trafopajka/Ochlasta/BOM-ideas.txt

MCU
----

I need something with good timers for PWM generation.
Good bet seems to be STM32 with HRTIM. Lets fisrt try STM32F334R8T6 (it has HRTIM and cheap nucleo board is available)

Synchronous converter
----

Power FET: Infineon IRFH7440 - 40V, 11A, RDS(on)=7.5mΩ, Qg=23nC (might work for both high and low sides)
Gate driver: TI UCC27282
https://jlcpcb.com/partdetail/InfineonTechnologies-IRFH7440TRPBF/C67862

https://jlcpcb.com/partdetail/TexasInstruments-UCC27282DR/C2867844
Inductor: By calculations I need about 20 uH minimum, preferably more
For 10 A there are some available 17.8x17 mm package 1770
Maybe like this
 https://jlcpcb.com/partdetail/SOREDE-SRYH_1770YF220MT00/C5122901

Measurement:
Shunt resistor something like this:
https://jlcpcb.com/partdetail/Milliohm-HoLLR1206_1W_5mR_1/C2988648
Amplifier like this:
https://jlcpcb.com/partdetail/TexasInstruments-INA240A2DR/C2060768

Current Measurement
----
TI INA240 seems nice

Connectors
----
https://www.tme.eu/cz/en/details/xt60pw-m/dc-power-connectors/amass/ XT60 for power
https://www.tme.eu/cz/en/details/keys3557-2/car-fuseholders/keystone/3557-2/ Fuse holder

for TEC module output I propose WAGO 236 series
https://www.gme.cz/v/1499152/wago-236-744-svorkovnice-1pol-roztec-508mm-24a-320v-vstup-45-pruzina
(or similar)

For RTDs:
https://www.tme.eu/cz/en/details/mc1.5_2-g-3.81/pluggable-terminal-blocks/phoenix-contact/1803277/
https://www.tme.eu/cz/en/details/mc1.5_2-st-3.81/pluggable-terminal-blocks/phoenix-contact/1803578/

DC DC for MCU power
L 3.6 uH https://jlcpcb.com/partdetail/179254-FNR4030S3R6MT/C167871
L 2.2 uH https://jlcpcb.com/partdetail/179130-FNR3015S2R2MT/C167747

Analog LDO
----
https://jlcpcb.com/partdetail/TexasInstruments-TPS7A4901DGNR/C16430

Display
----
https://www.aliexpress.com/item/4000832671813.html (version 2")

https://www.aliexpress.com/i/1005008964559903.html (SD card has different pinout, but I believe correct mechanical dravings)

https://goldenmorninglcd.com/tft-display-module/2-inch-240x320-st7789v-gmt020-02/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 (mecahnical drawings)

Encoder
https://www.tme.eu/cz/en/details/ec11e12-15p30c-sw/incremental-type-encoders/sr-passives/

buttons:

for debug/programming small SMD buttons https://jlcpcb.com/partdetail/XUNPU-TS_1088AR02016/C720477

for user interface something like this https://www.tme.eu/cz/en/details/tact-69k-f/microswitches-tact/ninigi/

Instrumentation amplifier
----
https://jlcpcb.com/partdetail/TexasInstruments-INA333AIDGKR/C19450 (for Pt1000 RTDs)

CAN
https://jlcpcb.com/partdetail/TexasInstruments-SN65HVD230DR/C12084
