trafopajka/Ochlasta/calculations/Wheatstone_1_sch.png

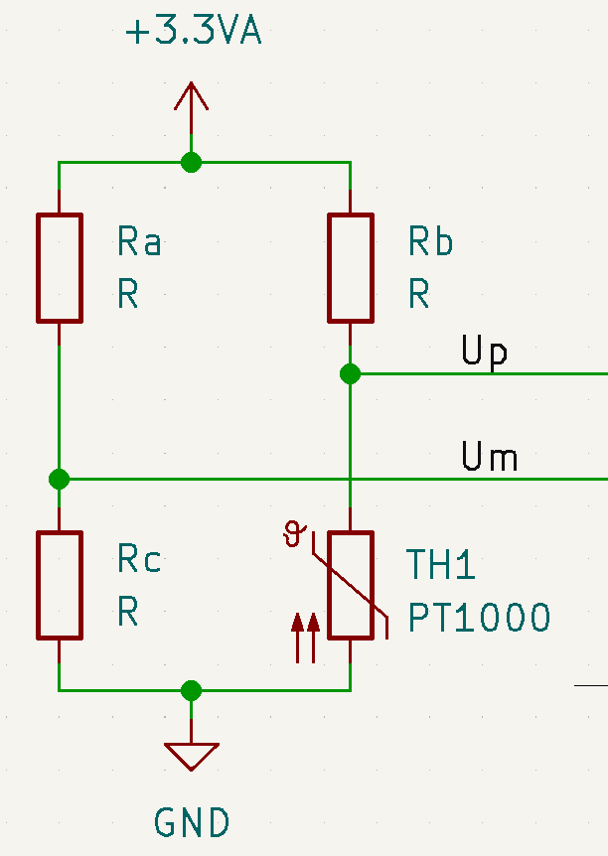
calculations/Wheatstone_1_sch.png
