trafopajka/Ochlasta/calculations/Wheatstone_2_sch.png

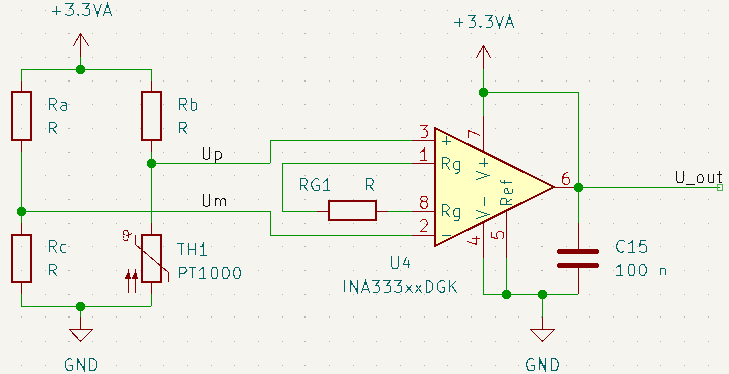
calculations/Wheatstone_2_sch.png
