trafopajka/Ochlasta/OchlastaPCB/SnapMagic_downloads/IRFH7440TRPBF.step

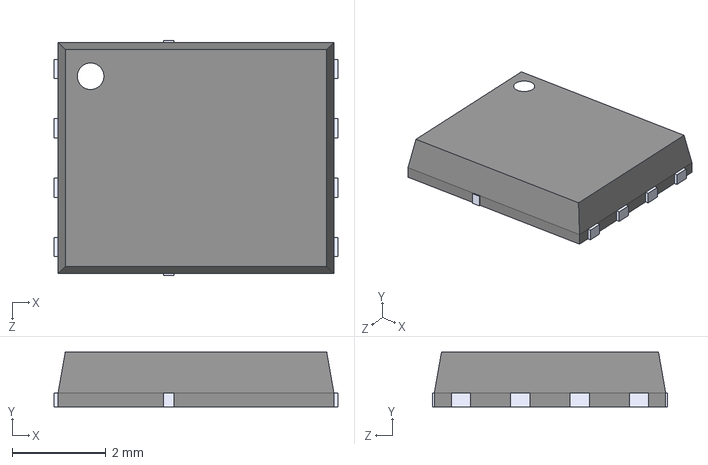
[picture p3: CAD file, 2025-11-04]
OchlastaPCB/SnapMagic_downloads/IRFH7440TRPBF.step
6.08 x 1.17 x 5.03 mm
