trafopajka/Ochlasta/OchlastaPCB/SnapMagic_downloads/TPS7A4901DGNR.step

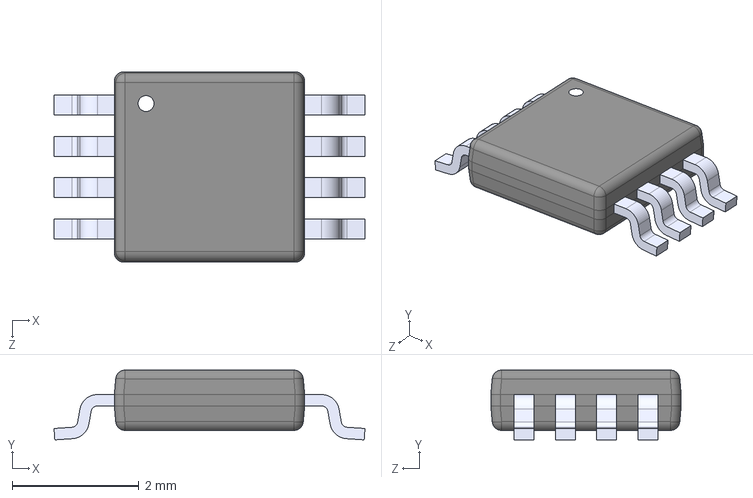
[picture p4: CAD file, 2025-10-30]
OchlastaPCB/SnapMagic_downloads/TPS7A4901DGNR.step
4.90 x 1.10 x 3.00 mm
