trafopajka/Ochlasta/OchlastaPCB/SnapMagic_downloads/XT60PW-M.step

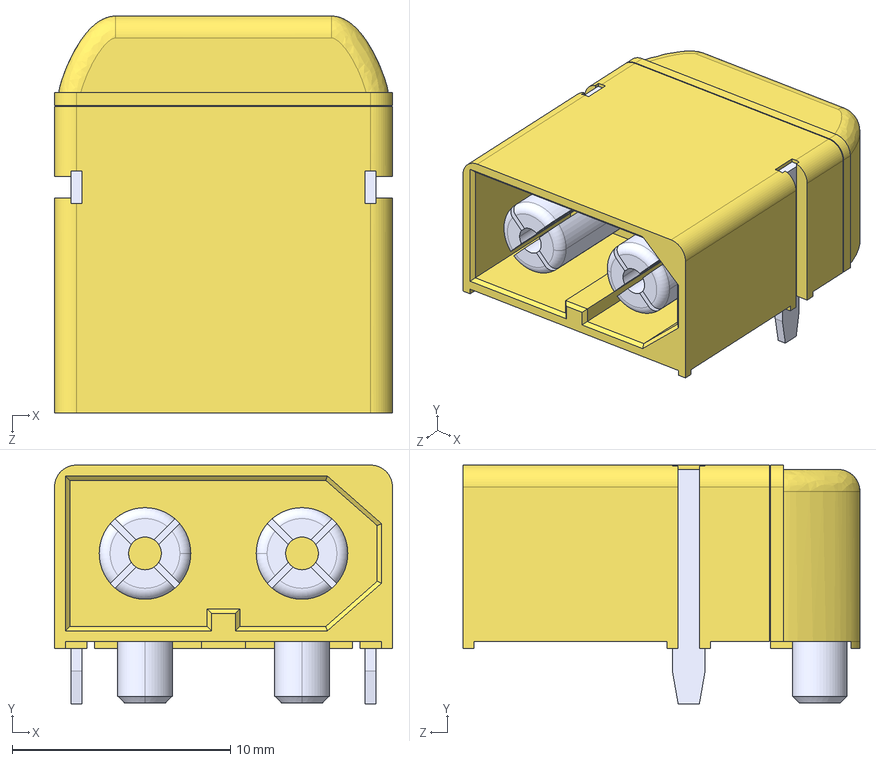
[picture p5: CAD file, 2025-10-27]
OchlastaPCB/SnapMagic_downloads/XT60PW-M.step
15.5 x 10.9 x 18.2 mm
