trafopajka/Ochlasta/OchlastaPCB/SnapMagic_downloads/UCC27282DR.step

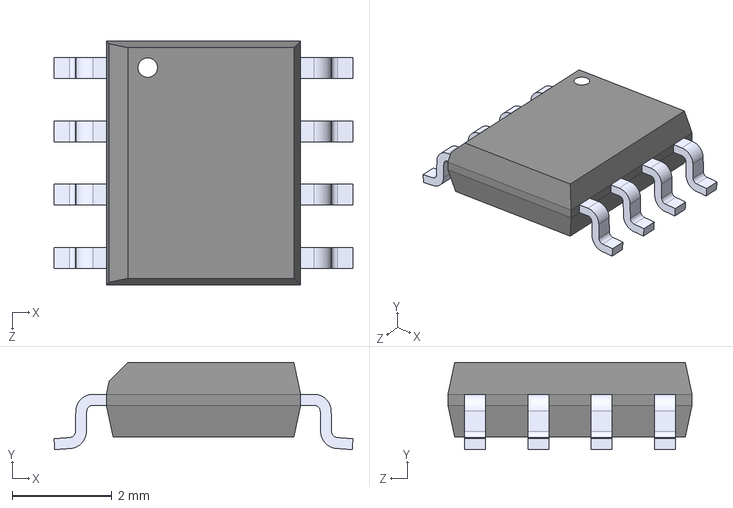
[picture p6: CAD file, 2025-11-04]
OchlastaPCB/SnapMagic_downloads/UCC27282DR.step
6.00 x 1.75 x 4.90 mm
