trafopajka/Ochlasta/OchlastaPCB/SnapMagic_downloads/AP64501SP-13.step

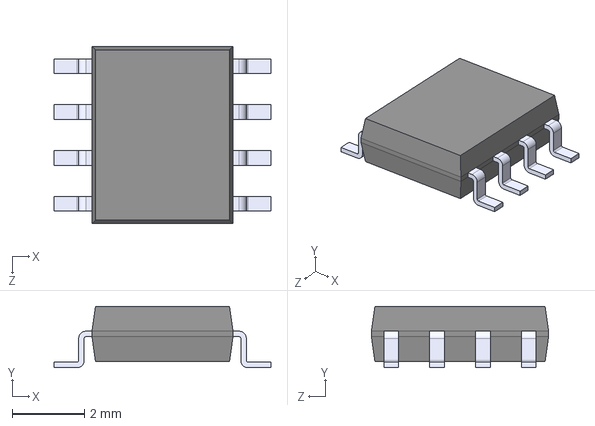
[picture p7: CAD file, 2025-10-27]
OchlastaPCB/SnapMagic_downloads/AP64501SP-13.step
6.00 x 1.70 x 4.90 mm
