trafopajka/Ochlasta/OchlastaPCB/OchlastaPCB.kicad_pcb

## KiCad design OchlastaPCB/OchlastaPCB.kicad_pcb (2025-11-10)

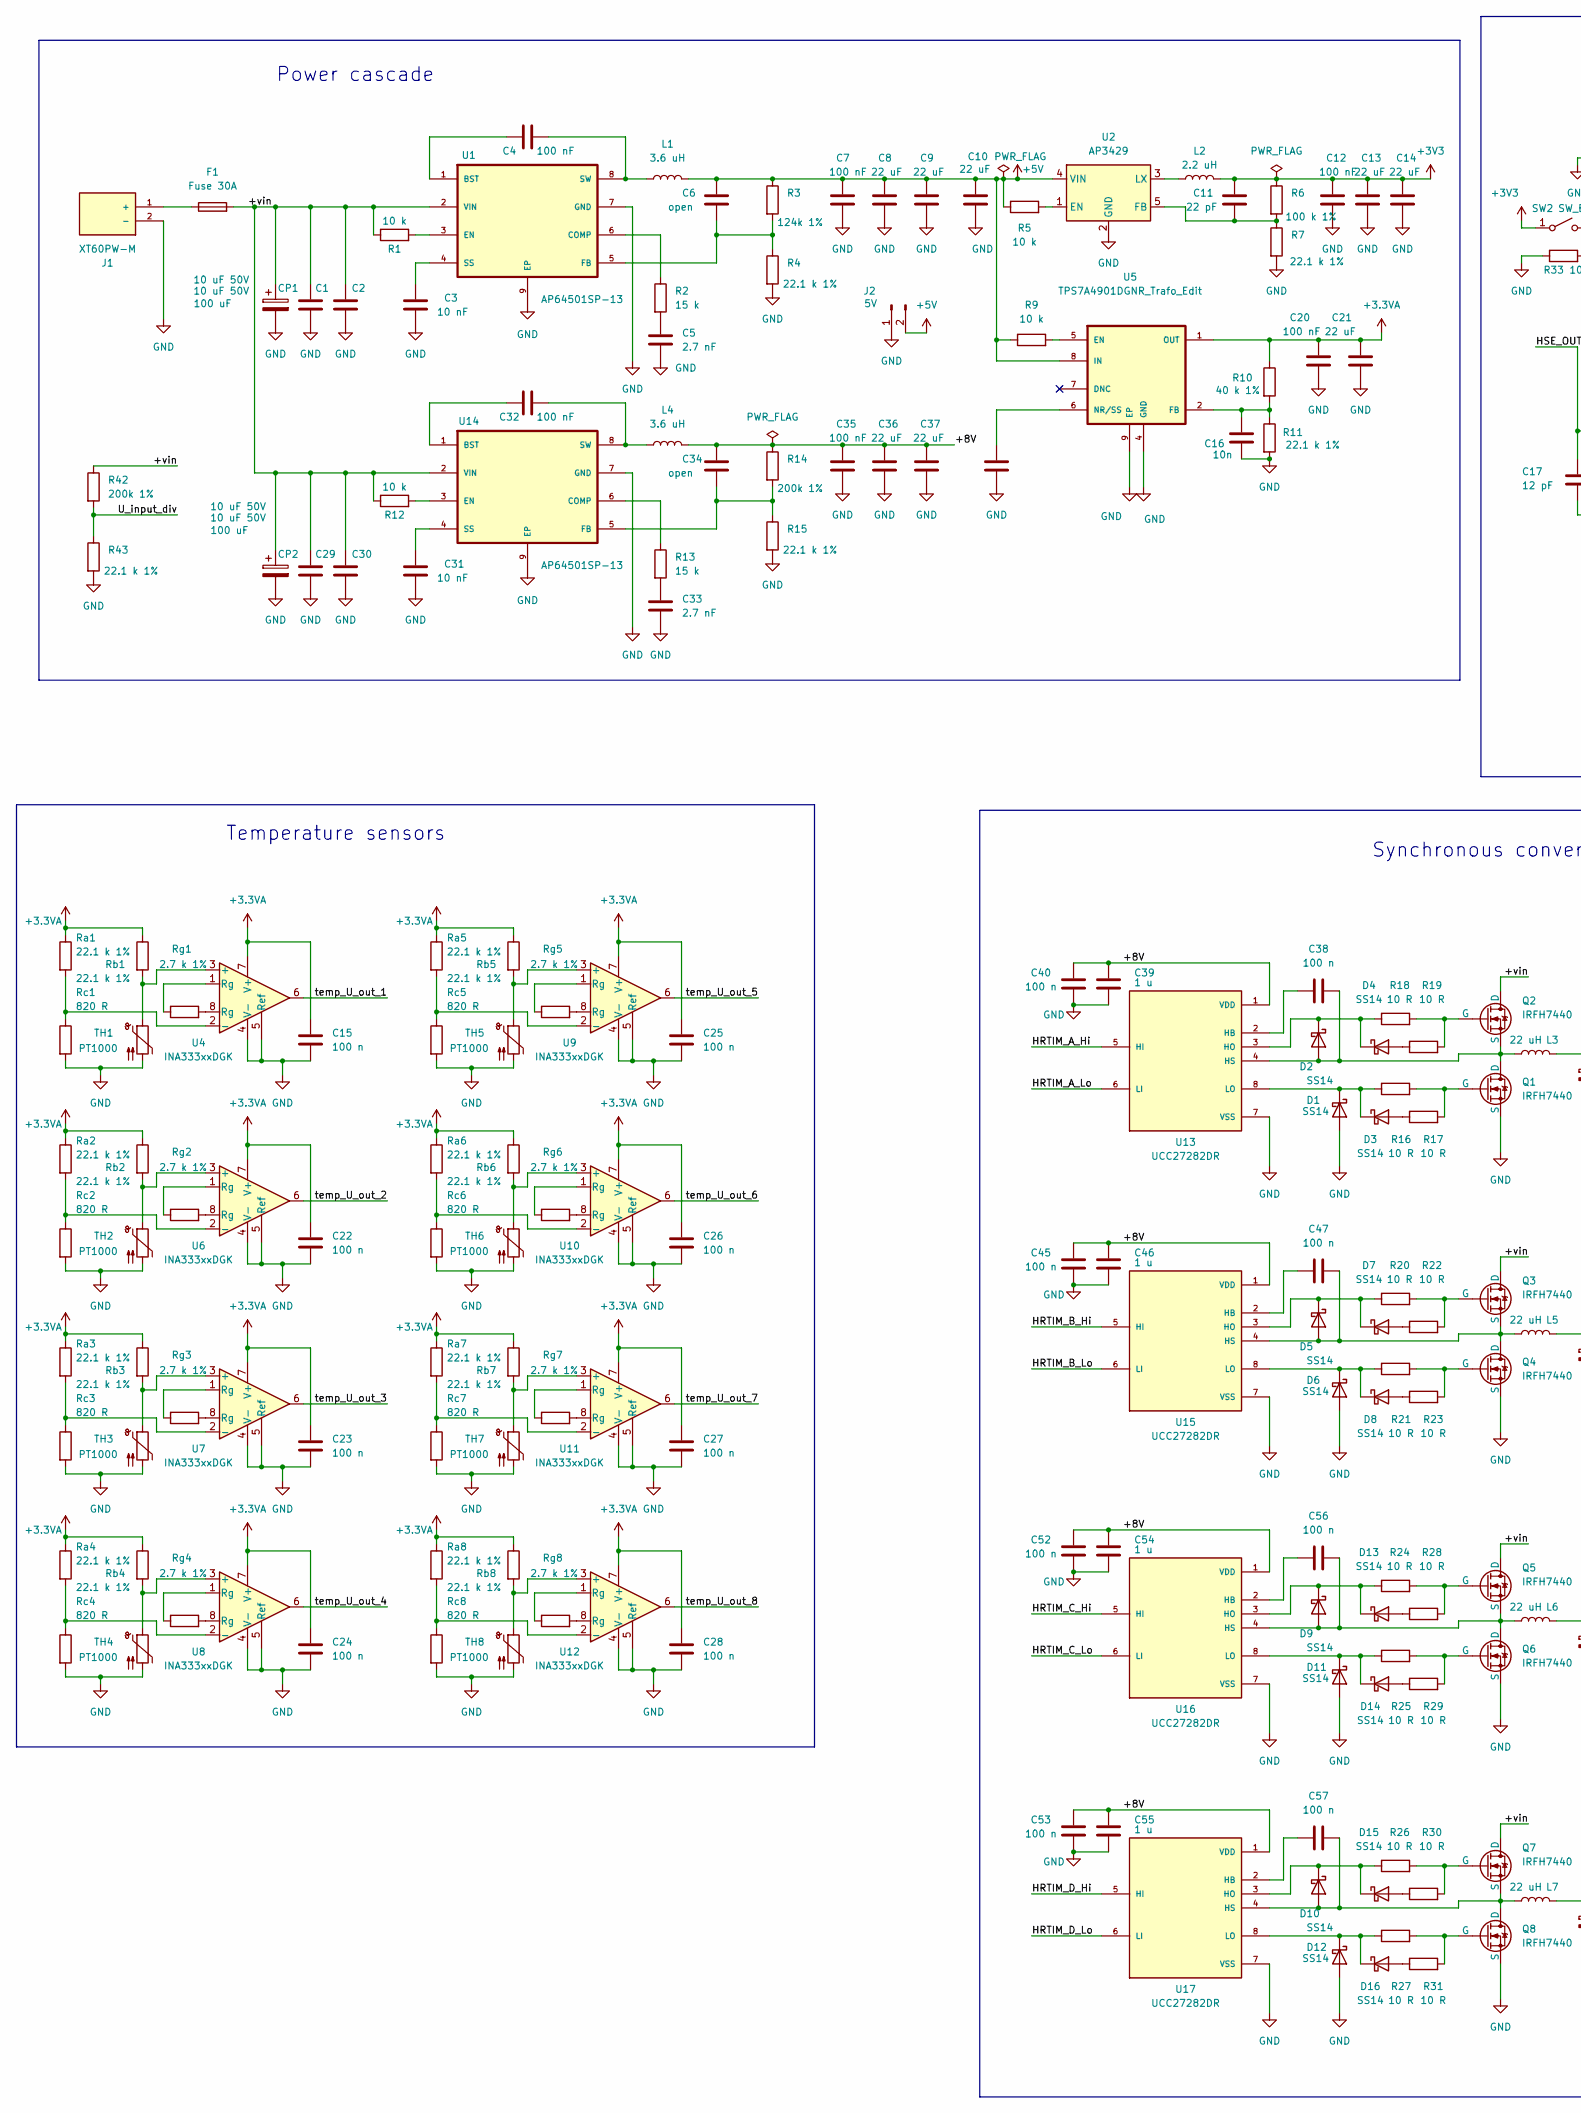
[picture p8: schematic OchlastaPCB.kicad_sch, Ochlasta, part in row 1, column 1]

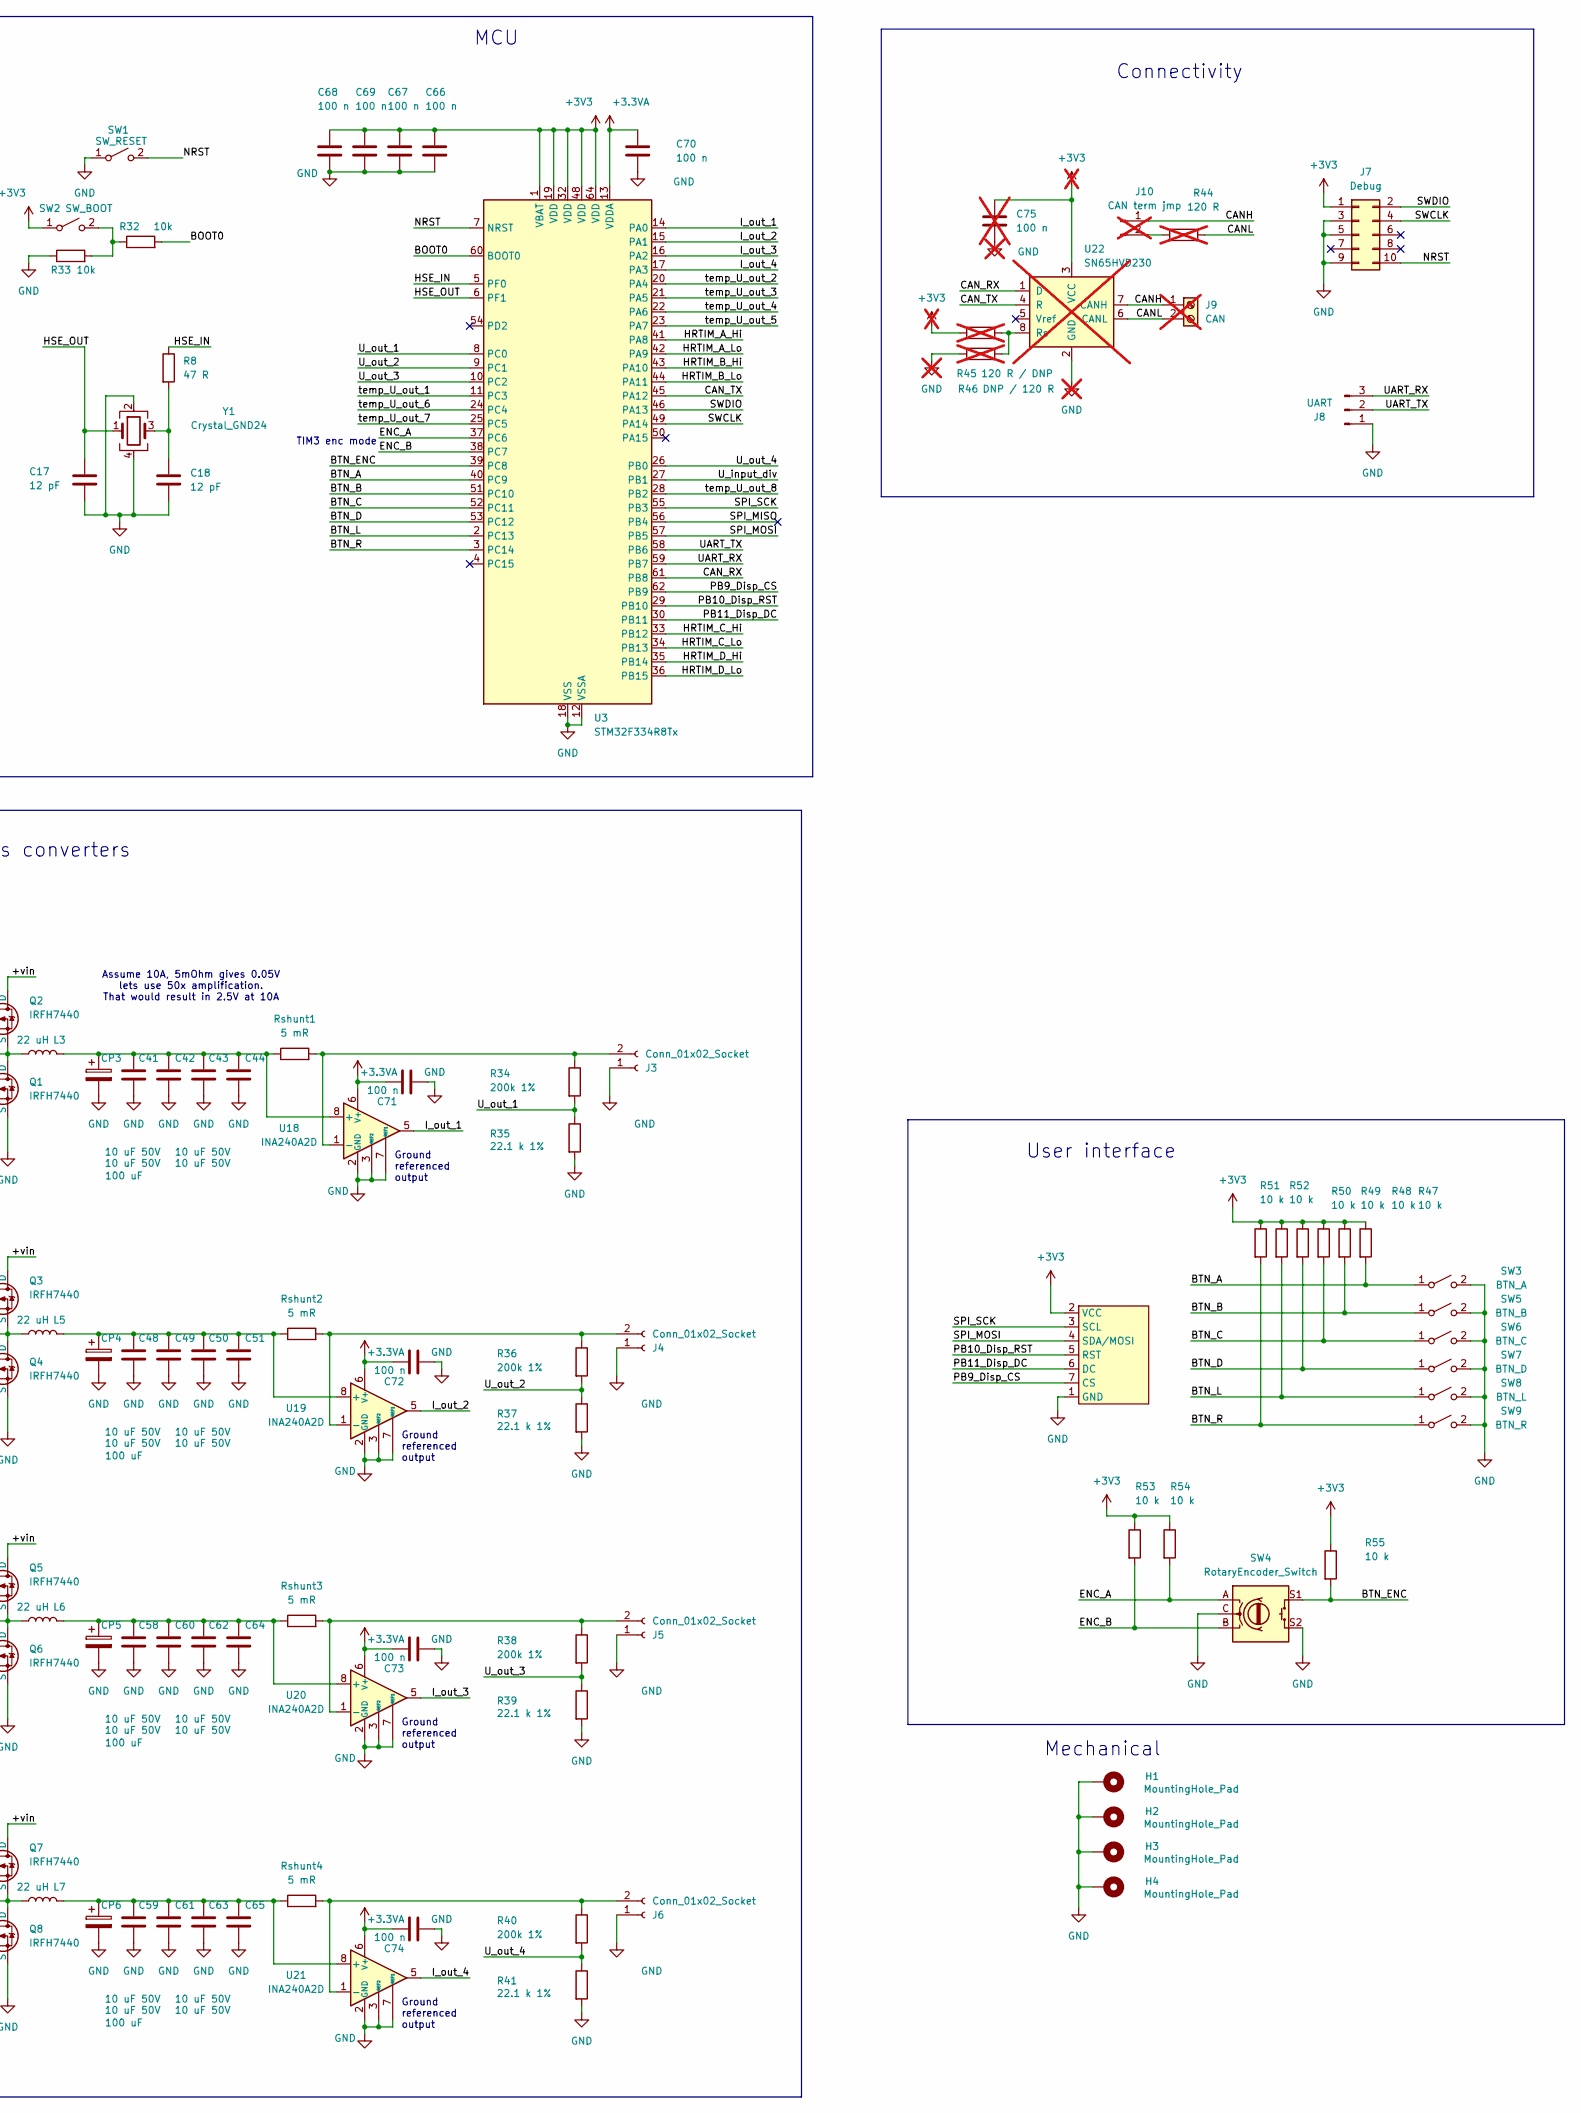
[picture p9: schematic OchlastaPCB.kicad_sch, Ochlasta, part in row 1, column 2]

Parts:
C1, C2, C29, C30, C41, C42, C43, C44, C48, C49, C50, C51, C58, C59, C60, C61, C62, C63, C64, C65: 10 uF 50V; C_1206_3216Metric
C3, C31: 10 nF; C_0603_1608Metric
C4, C7, C12, C20, C32, C35: 100 nF; C_0603_1608Metric
C5, C33: 2.7 nF; C_0603_1608Metric
C6, C34: open; C_0603_1608Metric
C8, C9, C10, C13, C14, C21, C36, C37: 22 uF; C_0805_2012Metric
C11: 22 pF; C_0603_1608Metric
C15, C22, C23, C24, C25, C26, C27, C28, C38, C40, C45, C47, C52, C53, C56, C57, C66, C67, C68, C69, C70, C71, C72, C73, C74: 100 n; C_0603_1608Metric
C16, C19: 10n; C_0603_1608Metric
C17, C18: 12 pF; C_0603_1608Metric
C39, C46, C54, C55: 1 u; C_0603_1608Metric
C75: 100 n; C_0603_1608Metric; not fitted
CP1, CP2, CP3, CP4, CP5, CP6: 100 uF; CP_Elec_8x10
D1, D2, D3, D4, D5, D6, D7, D8, D9, D10, D11, D12, D13, D14, D15, D16: SS14; D_SMA
F1: Fuse 30A; Fuseholder_Keystone_3557
H1, H2, H3, H4: MountingHole_Pad; MountingHole_3.2mm_M3_Pad_Via
J1: XT60PW-M; AMASS_XT60PW-M; PARTREV V1.2
J2: 5V; PinHeader_1x02_P2.54mm_Vertical
J3, J4, J5, J6: Conn_01x02_Socket; TerminalBlock_WAGO_236-402_1x02_P5.00mm_45Degree
J7: Debug; IDC-Header_2x05_P2.54mm_Vertical
J8: UART; PinHeader_1x03_P2.54mm_Vertical
J9: CAN; PhoenixContact_MC_1,5_2-G-3.81_1x02_P3.81mm_Horizontal; not fitted
J10: CAN term jmp; PinHeader_1x02_P2.54mm_Vertical; not fitted
L1, L4: 3.6 uH; L_Changjiang_FNR4030S
L2: 2.2 uH; L_Changjiang_FNR3015S
L3, L5, L6, L7: 22 uH; L_APV_APH1770
Q1, Q2, Q3, Q4, Q5, Q6, Q7, Q8: IRFH7440; PQFN_5x6_FET
R1, R5, R9, R12, R47, R48, R49, R50, R51, R52, R53, R54, R55: 10 k; R_0603_1608Metric
R2, R13: 15 k; R_0603_1608Metric
R3: 124k 1%; R_0603_1608Metric
R4, R7, R11, R15, R35, R37, R39, R41, R43: 22.1 k 1%; R_0603_1608Metric
R6: 100 k 1%; R_0603_1608Metric
R8: 47 R; R_0603_1608Metric
R10: 40 k 1%; R_0603_1608Metric
R14, R34, R36, R38, R40, R42: 200k 1%; R_0603_1608Metric
R16, R17, R18, R19, R20, R21, R22, R23, R24, R25, R26, R27, R28, R29, R30, R31: 10 R; R_0603_1608Metric
R32, R33: 10k; R_0603_1608Metric
R44: 120 R; R_0603_1608Metric; not fitted
R45: 120 R / DNP; R_0603_1608Metric; not fitted
R46: DNP / 120 R; R_0603_1608Metric; not fitted
Ra1, Ra2, Ra3, Ra4, Ra5, Ra6, Ra7, Ra8: 22.1 k 1%; R_0603_1608Metric
Rb1, Rb2, Rb3, Rb4, Rb5, Rb6, Rb7, Rb8: 22.1 k 1%; R_0603_1608Metric
Rc1, Rc2, Rc3, Rc4, Rc5, Rc6, Rc7, Rc8: 820 R; R_0603_1608Metric
Rg1, Rg2, Rg3, Rg4, Rg5, Rg6, Rg7, Rg8: 2.7 k 1%; R_0603_1608Metric
Rshunt1, Rshunt2, Rshunt3, Rshunt4: 5 mR; R_1206_3216Metric
SW1: SW_RESET; SW_Push_SPST_CheapAtJLC
SW2: SW_BOOT; SW_Push_SPST_CheapAtJLC
SW3: BTN_A; SW_PUSH_6mm
SW4: RotaryEncoder_Switch; RotaryEncoder_Alps_EC11E-Switch_Vertical_H20mm
SW5: BTN_B; SW_PUSH_6mm
SW6: BTN_C; SW_PUSH_6mm
SW7: BTN_D; SW_PUSH_6mm
SW8: BTN_L; SW_PUSH_6mm
SW9: BTN_R; SW_PUSH_6mm
TFT1: GMT020-02 TFT Display
TH1, TH2, TH3, TH4, TH5, TH6, TH7, TH8: PT1000; PhoenixContact_MC_1,5_2-G-3.81_1x02_P3.81mm_Horizontal
U1, U14: AP64501SP-13; SOIC127P600X170-9N
U2: AP3429; TSOT-23-5
U3: STM32F334R8Tx; LQFP-64_10x10mm_P0.5mm
U4, U6, U7, U8, U9, U10, U11, U12: INA333xxDGK; VSSOP-8_3x3mm_P0.65mm
U5: TPS7A4901DGNR_Trafo_Edit; SOP65P490X110-9N
U13, U15, U16, U17: UCC27282DR; SOIC127P599X175-8N; PARTREV A
U18, U19, U20, U21: INA240A2D; SOIC-8_3.9x4.9mm_P1.27mm
U22: SN65HVD230; SOIC-8_3.9x4.9mm_P1.27mm; not fitted
Y1: Crystal_GND24; Crystal_SMD_3225-4Pin_3.2x2.5mm

Connections:
+3.3VA: C15.1, C20.1, C21.1, C22.1, C23.1, C24.1, C25.1, C26.1, C27.1, C28.1, C70.1, C71.1, C72.1, C73.1, C74.1, R10.1, Ra1.1, Ra2.1, Ra3.1, Ra4.1, Ra5.1, Ra6.1, Ra7.1, Ra8.1, Rb1.1, Rb2.1, Rb3.1, Rb4.1, Rb5.1, Rb6.1, Rb7.1, Rb8.1, U3.13 (VDDA), U4.7 (V+), U5.1 (OUT), U6.7 (V+), U7.7 (V+), U8.7 (V+), U9.7 (V+), U10.7 (V+), U11.7 (V+), U12.7 (V+), U18.6 (V+), U19.6 (V+), U20.6 (V+), U21.6 (V+)
+3V3: C11.1, C12.1, C13.1, C14.1, C66.1, C67.1, C68.1, C69.1, C75.1, J7.1, L2.2, R6.1, R45.1, R47.1, R48.1, R49.1, R50.1, R51.1, R52.1, R53.1, R54.1, R55.1, SW2.1 (A), TFT1.2 (VCC), U3.1 (VBAT), U3.19 (VDD), U3.32 (VDD), U3.48 (VDD), U3.64 (VDD), U22.3 (VCC)
+5V: C6.1, C7.1, C8.1, C9.1, C10.1, J2.2, L1.2, R3.1, R5.1, R9.1, U2.4 (VIN), U5.8 (IN)
/+8V: C34.1, C35.1, C36.1, C37.1, C39.2, C40.2, C45.2, C46.2, C52.2, C53.2, C54.2, C55.2, L4.2, R14.1, U13.1 (VDD), U15.1 (VDD), U16.1 (VDD), U17.1 (VDD)
/+vin: C1.1, C2.1, C29.1, C30.1, CP1.1, CP2.1, F1.2, Q2.1 (D), Q3.1 (D), Q5.1 (D), Q7.1 (D), R1.1, R12.1, R42.1, U1.2 (VIN), U14.2 (VIN)
/BOOT0: R32.2, U3.60 (BOOT0)
/BTN_A: R47.2, SW3.1 (A), U3.40 (PC9)
/BTN_B: R48.2, SW5.1 (A), U3.51 (PC10)
/BTN_C: R49.2, SW6.1 (A), U3.52 (PC11)
/BTN_D: R50.2, SW7.1 (A), U3.53 (PC12)
/BTN_ENC: R55.2, SW4.S1, U3.39 (PC8)
/BTN_L: R52.2, SW8.1 (A), U3.2 (PC13)
/BTN_R: R51.2, SW9.1 (A), U3.3 (PC14)
/CANH: J9.1, J10.1, U22.7 (CANH)
/CANL: J9.2, R44.2, U22.6 (CANL)
/CAN_RX: U3.61 (PB8), U22.1 (D)
/CAN_TX: U3.45 (PA12), U22.4 (R)
/ENC_A: R54.2, SW4.A, U3.37 (PC6)
/ENC_B: R53.2, SW4.B, U3.38 (PC7)
/HRTIM_A_Hi: U3.41 (PA8), U13.5 (HI)
/HRTIM_A_Lo: U3.42 (PA9), U13.6 (LI)
/HRTIM_B_Hi: U3.43 (PA10), U15.5 (HI)
/HRTIM_B_Lo: U3.44 (PA11), U15.6 (LI)
/HRTIM_C_Hi: U3.33 (PB12), U16.5 (HI)
/HRTIM_C_Lo: U3.34 (PB13), U16.6 (LI)
/HRTIM_D_Hi: U3.35 (PB14), U17.5 (HI)
/HRTIM_D_Lo: U3.36 (PB15), U17.6 (LI)
/HSE_IN: R8.1, U3.5 (PF0)
/HSE_OUT: C17.1, U3.6 (PF1), Y1.1
/I_out_1: U3.14 (PA0), U18.5
/I_out_2: U3.15 (PA1), U19.5
/I_out_3: U3.16 (PA2), U20.5
/I_out_4: U3.17 (PA3), U21.5
/NRST: J7.10, SW1.2 (B), U3.7 (NRST)
/PB9_Disp_CS: TFT1.7 (CS), U3.62 (PB9)
/PB10_Disp_RST: TFT1.5 (RST), U3.29 (PB10)
/PB11_Disp_DC: TFT1.6 (DC), U3.30 (PB11)
/SPI_MISO: U3.56 (PB4)
/SPI_MOSI: TFT1.4 (SDA/MOSI), U3.57 (PB5)
/SPI_SCK: TFT1.3 (SCL), U3.55 (PB3)
/SWCLK: J7.4, U3.49 (PA14)
/SWDIO: J7.2, U3.46 (PA13)
/UART_RX: J8.3, U3.59 (PB7)
/UART_TX: J8.2, U3.58 (PB6)
/U_input_div: R42.2, R43.1, U3.27 (PB1)
/U_out_1: R34.2, R35.1, U3.8 (PC0)
/U_out_2: R36.2, R37.1, U3.9 (PC1)
/U_out_3: R38.2, R39.1, U3.10 (PC2)
/U_out_4: R40.2, R41.1, U3.26 (PB0)
/temp_U_out_1: U3.11 (PC3), U4.6
/temp_U_out_2: U3.20 (PA4), U6.6
/temp_U_out_3: U3.21 (PA5), U7.6
/temp_U_out_4: U3.22 (PA6), U8.6
/temp_U_out_5: U3.23 (PA7), U9.6
/temp_U_out_6: U3.24 (PC4), U10.6
/temp_U_out_7: U3.25 (PC5), U11.6
/temp_U_out_8: U3.28 (PB2), U12.6
GND: C1.2, C2.2, C3.2, C5.2, C7.2, C8.2, C9.2, C10.2, C12.2, C13.2, C14.2, C15.2, C16.2, C17.2, C18.2, C19.2, C20.2, C21.2, C22.2, C23.2, C24.2, C25.2, C26.2, C27.2, C28.2, C29.2, C30.2, C31.2, C33.2, C35.2, C36.2, C37.2, C39.1, C40.1, C41.2, C42.2, C43.2, C44.2, C45.1, C46.1, C48.2, C49.2, C50.2, C51.2, C52.1, C53.1, C54.1, C55.1, C58.2, C59.2, C60.2, C61.2, C62.2, C63.2, C64.2, C65.2, C66.2, C67.2, C68.2, C69.2, C70.2, C71.2, C72.2, C73.2, C74.2, C75.2, CP1.2, CP2.2, CP3.2, CP4.2, CP5.2, CP6.2, D1.2 (A), D6.2 (A), D11.2 (A), D12.2 (A), H1.1, H2.1, H3.1, H4.1, J1.2 (-), J2.1, J3.1, J4.1, J5.1, J6.1, J7.3, J7.5, J7.9, J8.1, Q1.3 (S), Q4.3 (S), Q6.3 (S), Q8.3 (S), R4.2, R7.2, R11.2, R15.2, R33.1, R35.2, R37.2, R39.2, R41.2, R43.2, R46.1, Rc1.2, Rc2.2, Rc3.2, Rc4.2, Rc5.2, Rc6.2, Rc7.2, Rc8.2, SW1.1 (A), SW3.2 (B), SW4.C, SW4.S2, SW5.2 (B), SW6.2 (B), SW7.2 (B), SW8.2 (B), SW9.2 (B), TFT1.1 (GND), TH1.2, TH2.2, TH3.2, TH4.2, TH5.2, TH6.2, TH7.2, TH8.2, U1.7 (GND), U1.9 (EP), U2.2 (GND), U3.12 (VSSA), U3.18 (VSS), U3.31 (VSS), U3.47 (VSS), U3.63 (VSS), U4.4 (V-), U4.5 (Ref), U5.4 (GND), U5.9 (EP), U6.4 (V-), U6.5 (Ref), U7.4 (V-), U7.5 (Ref), U8.4 (V-), U8.5 (Ref), U9.4 (V-), U9.5 (Ref), U10.4 (V-), U10.5 (Ref), U11.4 (V-), U11.5 (Ref), U12.4 (V-), U12.5 (Ref), U13.7 (VSS), U14.7 (GND), U14.9 (EP), U15.7 (VSS), U16.7 (VSS), U17.7 (VSS), U18.2 (GND), U18.3 (REF2), U18.4 (GND), U18.7 (REF1), U19.2 (GND), U19.3 (REF2), U19.4 (GND), U19.7 (REF1), U20.2 (GND), U20.3 (REF2), U20.4 (GND), U20.7 (REF1), U21.2 (GND), U21.3 (REF2), U21.4 (GND), U21.7 (REF1), U22.2 (GND), Y1.2, Y1.4
unnamed: C5.1, R2.2
unnamed: C18.1, R8.2, Y1.3
unnamed: C33.1, R13.2
unnamed: D1.1 (K), D3.1 (K), R16.1, U13.8 (LO)
unnamed: C38.2, D2.2 (A), L3.1, Q1.1 (D), Q2.3 (S), U13.4 (HS)
unnamed: D2.1 (K), D4.1 (K), R18.1, U13.3 (HO)
unnamed: D3.2 (A), R17.1
unnamed: D4.2 (A), R19.1
unnamed: C47.2, D5.2 (A), L5.1, Q3.3 (S), Q4.1 (D), U15.4 (HS)
unnamed: D5.1 (K), D7.1 (K), R20.1, U15.3 (HO)
unnamed: D6.1 (K), D8.1 (K), R21.1, U15.8 (LO)
unnamed: D7.2 (A), R22.1
unnamed: D8.2 (A), R23.1
unnamed: C56.2, D9.2 (A), L6.1, Q5.3 (S), Q6.1 (D), U16.4 (HS)
unnamed: C57.2, D10.2 (A), L7.1, Q7.3 (S), Q8.1 (D), U17.4 (HS)
unnamed: D10.1 (K), D15.1 (K), R26.1, U17.3 (HO)
unnamed: D11.1 (K), D14.1 (K), R25.1, U16.8 (LO)
unnamed: D12.1 (K), D16.1 (K), R27.1, U17.8 (LO)
unnamed: D13.2 (A), R28.1
unnamed: D9.1 (K), D13.1 (K), R24.1, U16.3 (HO)
unnamed: D14.2 (A), R29.1
unnamed: D15.2 (A), R30.1
unnamed: D16.2 (A), R31.1
unnamed: F1.1, J1.1 (+)
unnamed: J3.2, R34.1, Rshunt1.2, U18.1 (-)
unnamed: J4.2, R36.1, Rshunt2.2, U19.1 (-)
unnamed: J5.2, R38.1, Rshunt3.2, U20.1 (-)
unnamed: J6.2, R40.1, Rshunt4.2, U21.1 (-)
unnamed: J10.2, R44.1
unnamed: Q1.2 (G), R16.2, R17.2
unnamed: Q2.2 (G), R18.2, R19.2
unnamed: Q3.2 (G), R20.2, R22.2
unnamed: Q4.2 (G), R21.2, R23.2
unnamed: Q5.2 (G), R24.2, R28.2
unnamed: Q6.2 (G), R25.2, R29.2
unnamed: Q7.2 (G), R26.2, R30.2
unnamed: Q8.2 (G), R27.2, R31.2
unnamed: Rg1.1, U4.1 (Rg)
unnamed: Rg1.2, U4.8 (Rg)
unnamed: Rg2.1, U6.1 (Rg)
unnamed: Rg2.2, U6.8 (Rg)
unnamed: Rg3.1, U7.1 (Rg)
unnamed: Rg3.2, U7.8 (Rg)
unnamed: Rg4.1, U8.1 (Rg)
unnamed: Rg4.2, U8.8 (Rg)
unnamed: Rg5.1, U9.1 (Rg)
unnamed: Rg5.2, U9.8 (Rg)
unnamed: Rg6.1, U10.1 (Rg)
unnamed: Rg6.2, U10.8 (Rg)
unnamed: Rg7.1, U11.1 (Rg)
unnamed: Rg7.2, U11.8 (Rg)
unnamed: Rg8.1, U12.1 (Rg)
unnamed: Rg8.2, U12.8 (Rg)
unnamed: R32.1, R33.2, SW2.2 (B)
unnamed: C4.1, U1.1 (BST)
unnamed: R2.1, U1.6 (COMP)
unnamed: R1.2, U1.3 (EN)
unnamed: C6.2, R3.2, R4.1, U1.5 (FB)
unnamed: C3.1, U1.4 (SS)
unnamed: C4.2, L1.1, U1.8 (SW)
unnamed: R5.2, U2.1 (EN)
unnamed: C11.2, R6.2, R7.1, U2.5 (FB)
unnamed: L2.1, U2.3 (LX)
unnamed: Rb1.2, TH1.1, U4.3 (+)
unnamed: Ra1.2, Rc1.1, U4.2 (-)
unnamed: R9.2, U5.5 (EN)
unnamed: C16.1, R10.2, R11.1, U5.2 (FB)
unnamed: C19.1, U5.6 (NR/SS)
unnamed: Rb2.2, TH2.1, U6.3 (+)
unnamed: Ra2.2, Rc2.1, U6.2 (-)
unnamed: Rb3.2, TH3.1, U7.3 (+)
unnamed: Ra3.2, Rc3.1, U7.2 (-)
unnamed: Rb4.2, TH4.1, U8.3 (+)
unnamed: Ra4.2, Rc4.1, U8.2 (-)
unnamed: Rb5.2, TH5.1, U9.3 (+)
unnamed: Ra5.2, Rc5.1, U9.2 (-)
unnamed: Rb6.2, TH6.1, U10.3 (+)
unnamed: Ra6.2, Rc6.1, U10.2 (-)
unnamed: Rb7.2, TH7.1, U11.3 (+)
unnamed: Ra7.2, Rc7.1, U11.2 (-)
unnamed: Rb8.2, TH8.1, U12.3 (+)
unnamed: Ra8.2, Rc8.1, U12.2 (-)
unnamed: C38.1, U13.2 (HB)
unnamed: C32.1, U14.1 (BST)
unnamed: R13.1, U14.6 (COMP)
unnamed: R12.2, U14.3 (EN)
unnamed: C34.2, R14.2, R15.1, U14.5 (FB)
unnamed: C31.1, U14.4 (SS)
unnamed: C32.2, L4.1, U14.8 (SW)
unnamed: C47.1, U15.2 (HB)
unnamed: C56.1, U16.2 (HB)
unnamed: C57.1, U17.2 (HB)
unnamed: C41.1, C42.1, C43.1, C44.1, CP3.1, L3.2, Rshunt1.1, U18.8 (+)
unnamed: C48.1, C49.1, C50.1, C51.1, CP4.1, L5.2, Rshunt2.1, U19.8 (+)
unnamed: C58.1, C60.1, C62.1, C64.1, CP5.1, L6.2, Rshunt3.1, U20.8 (+)
unnamed: C59.1, C61.1, C63.1, C65.1, CP6.1, L7.2, Rshunt4.1, U21.8 (+)
unnamed: R45.2, R46.2, U22.8 (Rs)

Notes on the sheet:
Temperature sensors
Power cascade
User interface
Ground referenced output
Connectivity
MCU
Synchronous converters
Mechanical
TIM3 enc mode
Assume 10A, 5mOhm gives 0.05V lets use 50x amplification. That would result in 2.5V at 10A

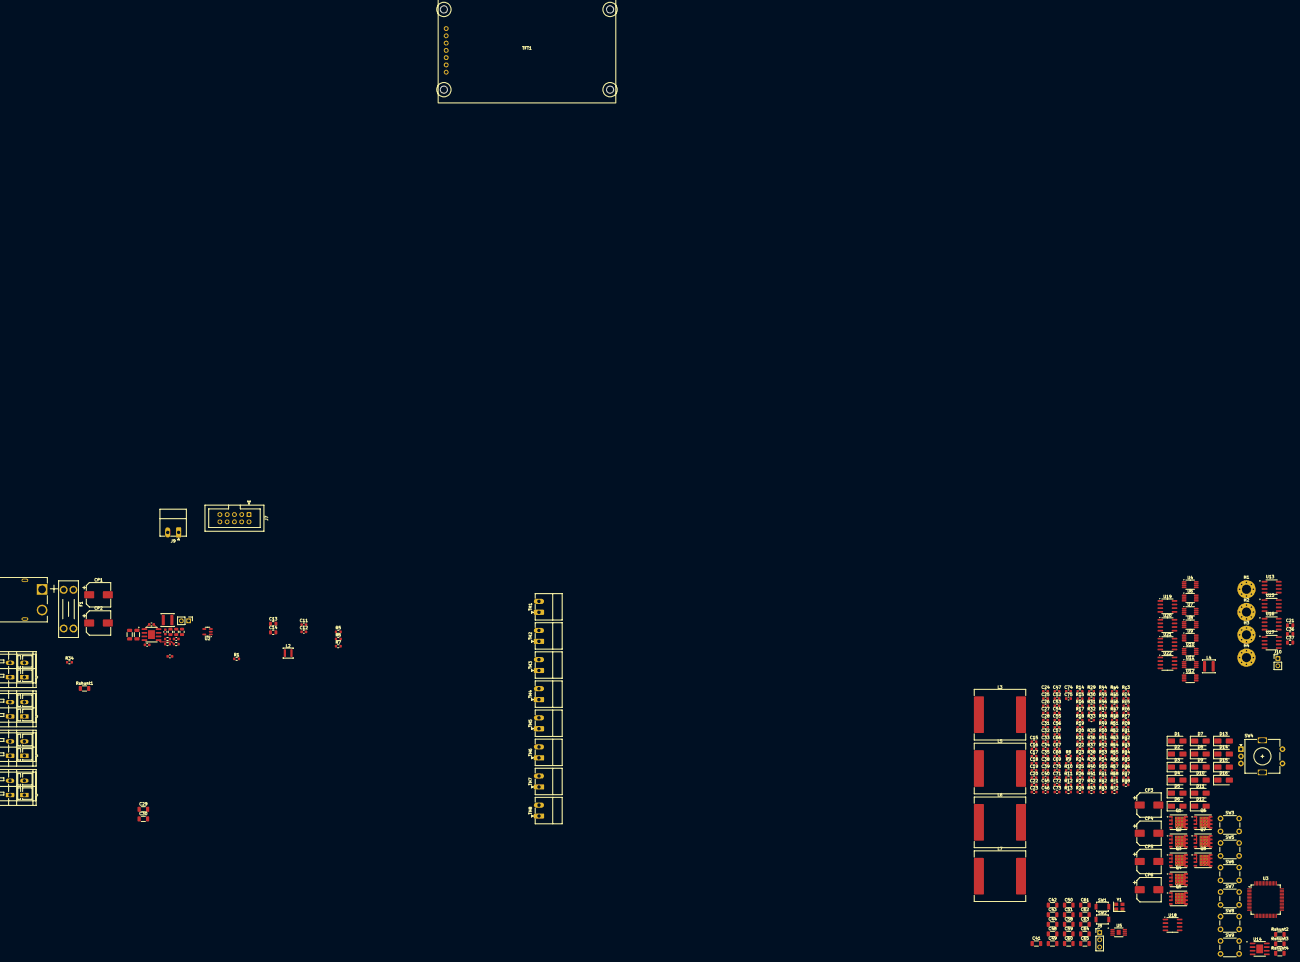
[picture p10: board OchlastaPCB.kicad_pcb from above]

Board: 4 copper layers, 259 parts (0 on the bottom side), 154 nets.
