trafopajka/Ochlasta/(commit log)

2025-10-09 some brainstorming ideas for HW
    [OchlastaPCB.kicad_pcb, OchlastaPCB.kicad_sch]
2025-10-09 MCU pins first thoughts
    [MCU_pins.ods]
2025-10-11 Preliminary MCU pinout
    [MCU_pins.ods]
2025-10-27 Power cascade for MCU schematics, created few components...
    [AP64501SP-13.step, OchlastaPCB.kicad_sch, XT60PW-M.step]
2025-10-27 preliminary Pt1000 analog readout circuitry design and calculation in jupyter notebook
    [MCU_pins.ods, OchlastaPCB.kicad_sch]
2025-10-30 Precision LDO for analog circuitry in schematics
    [OchlastaPCB.kicad_pcb, OchlastaPCB.kicad_sch, TPS7A4901DGNR.step]
2025-11-04 Schematics for one channel of main buck converter done I guess
    [IRFH7440TRPBF.step, OchlastaPCB.kicad_sch, UCC27282DR.step]
2025-11-08 Schematics done except for CAN transciever
    [MCU_pins.ods, OchlastaPCB.kicad_sch]
2025-11-10 Schematics complete I guess
    [OchlastaPCB.kicad_sch]
2025-11-10 Schematics seems finished, starting PCB design
    [OchlastaPCB.kicad_pcb, OchlastaPCB.kicad_sch]
